OmarNeazyI/Scoppy-Oscilloscope-rp2040-PCB/images/README.md

# Project photographs

## Presentation photographs

| View | Presentation image | Original photograph |
|---|---|---|
| Enclosure | [Enclosure presentation](enclosure-presentation.png) | [Original enclosure](enclosure-original.jpg) |
| PCB component side | [PCB top presentation](pcb-top-presentation.png) | [Original PCB top](pcb-top-original.jpg) |
| PCB underside | [PCB underside presentation](pcb-bottom-presentation.png) | [Original PCB underside](pcb-bottom-original.jpg) |

## PCB design views

- [Revision A PCB layout](pcb-layout-revision-a.png) · [Original layout screenshot](pcb-layout-source.png)
- [Revision A 3D view](pcb-3d-revision-a.png) · [Original 3D screenshot](pcb-3d-source.png)
- [Revision B PCB layout](pcb-layout-revision-b.png)
- [Revision B 3D view](pcb-3d-revision-b.png)

## Additional build photographs

- [Angled PCB view](pcb-angle-original.jpg)
- [USB panel](usb-panel-original.jpg)
- [Enclosure underside](enclosure-bottom-original.jpg)

The main project page uses the presentation photographs. The original photographs are included here as additional build documentation.

[Project overview](../README.md) · [Revision A source files](../hardware/revision-a/) · [Revision B source files](../hardware/revision-b/)
