OmarNeazyI/Scoppy-Oscilloscope-rp2040-PCB/images/enclosure-bottom-original.jpg

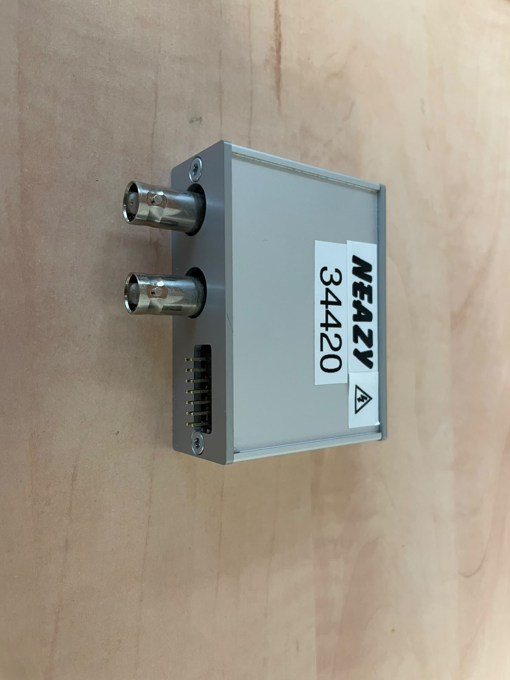
images/enclosure-bottom-original.jpg
