OmarNeazyI/Scoppy-Oscilloscope-rp2040-PCB/images/enclosure-original.jpg

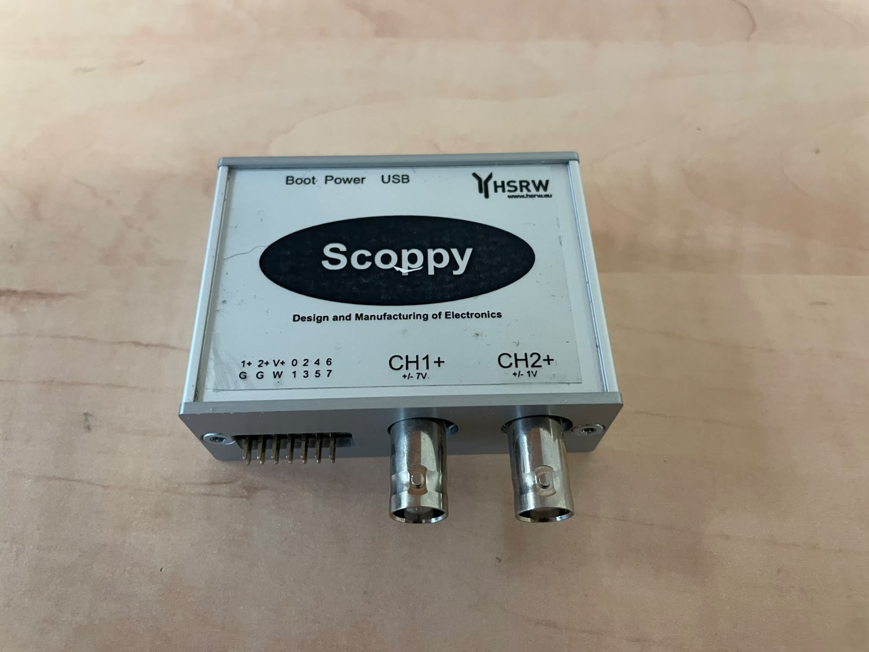
images/enclosure-original.jpg
