OmarNeazyI/Scoppy-Oscilloscope-rp2040-PCB/images/pcb-3d-source.png

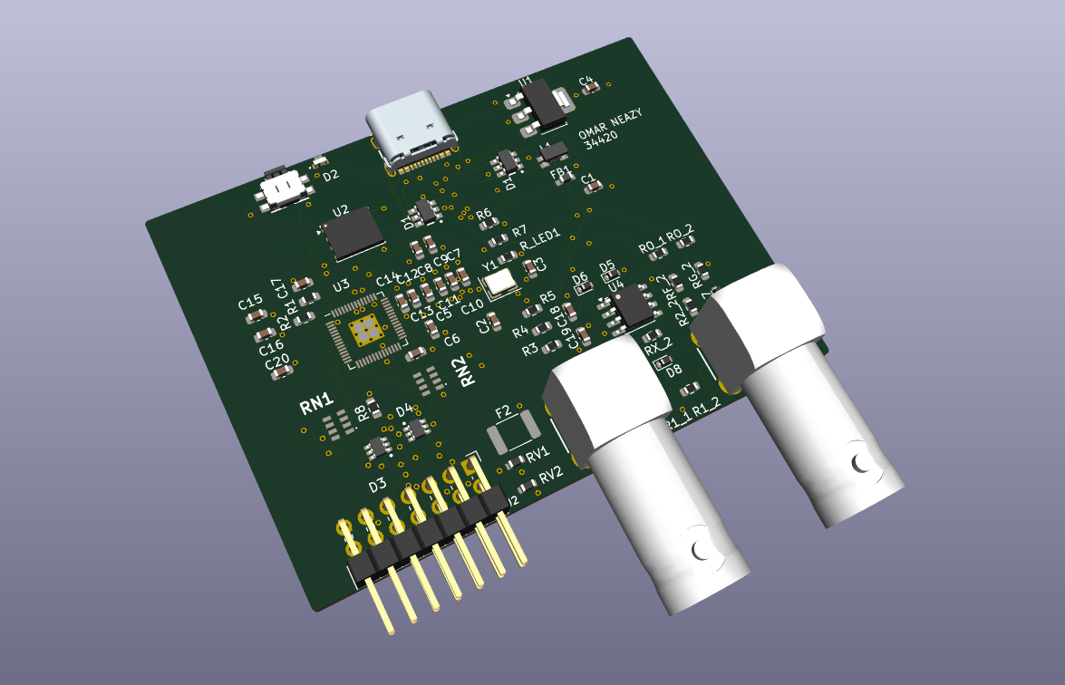
images/pcb-3d-source.png
