OmarNeazyI/Scoppy-Oscilloscope-rp2040-PCB/images/pcb-angle-original.jpg

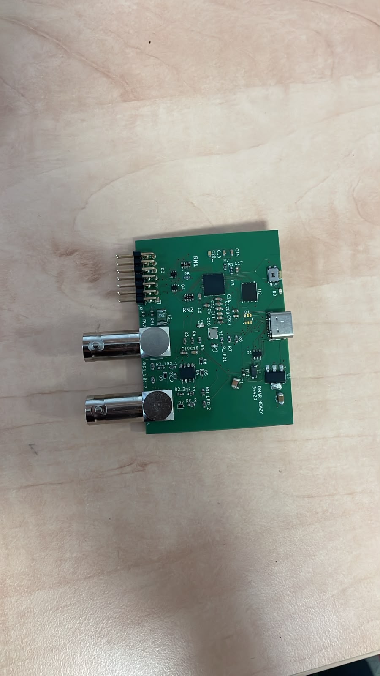
images/pcb-angle-original.jpg
