OmarNeazyI/Scoppy-Oscilloscope-rp2040-PCB/images/pcb-bottom-original.jpg

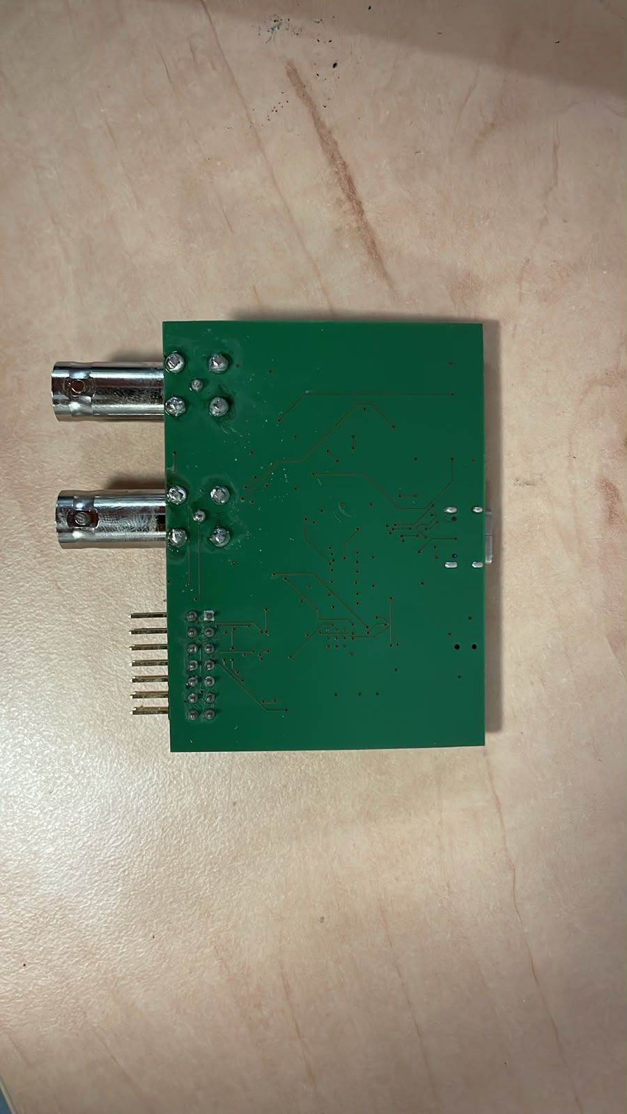
images/pcb-bottom-original.jpg
