OmarNeazyI/Scoppy-Oscilloscope-rp2040-PCB/images/pcb-layout-source.png

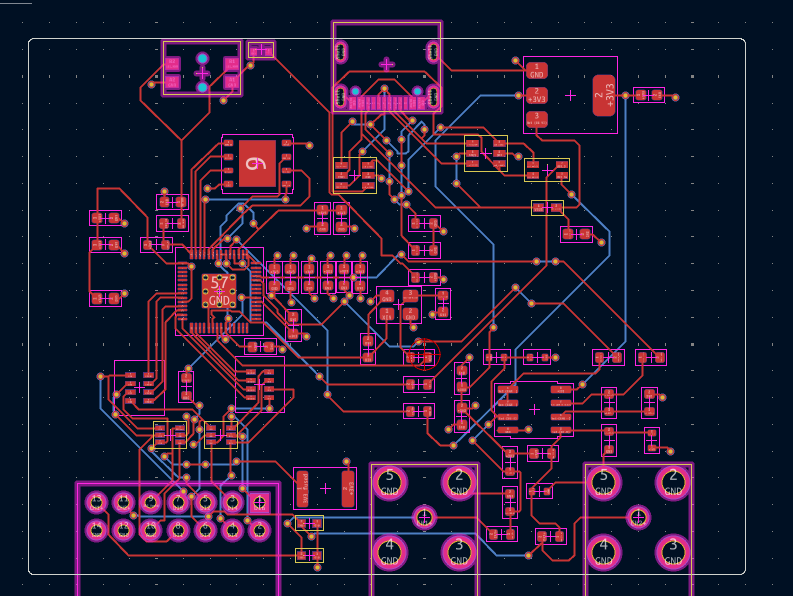
images/pcb-layout-source.png
