OmarNeazyI/Scoppy-Oscilloscope-rp2040-PCB/images/pcb-top-original.jpg

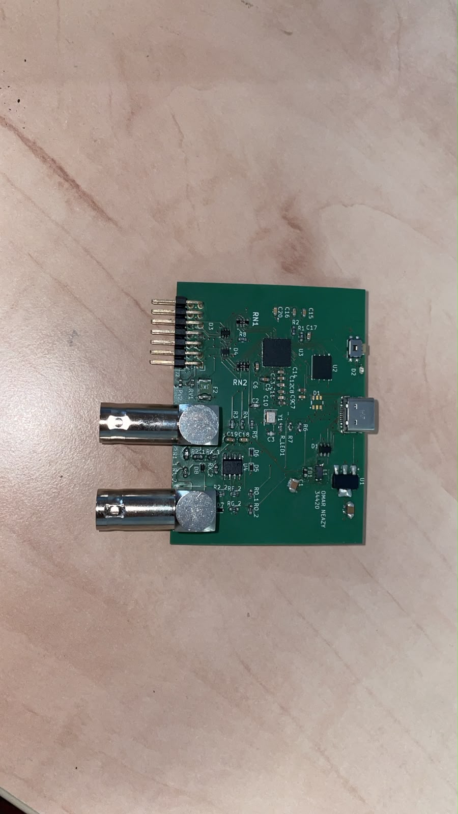
images/pcb-top-original.jpg
