OmarNeazyI/Scoppy-Oscilloscope-rp2040-PCB/images/usb-panel-original.jpg

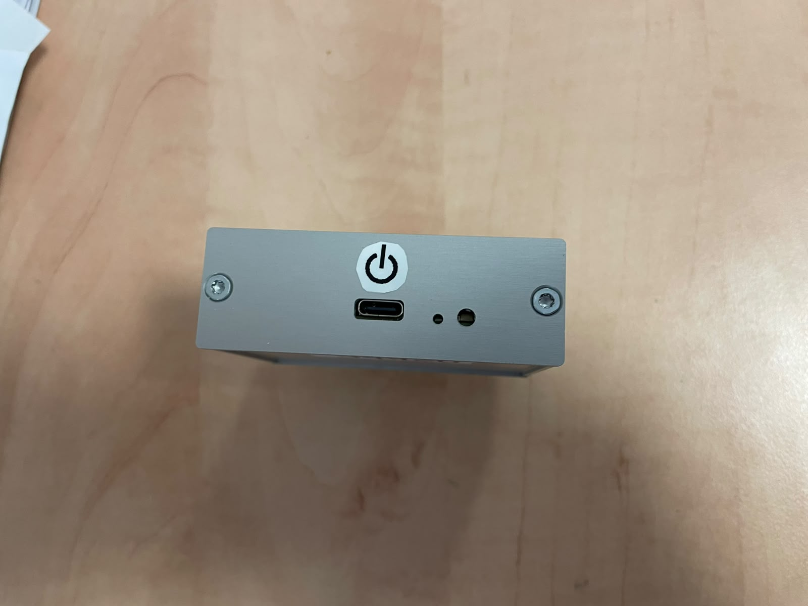
images/usb-panel-original.jpg
