OmarNeazyI/Scoppy-Oscilloscope-rp2040-PCB/hardware/revision-b/Scoppy_Revision_B.kicad_pcb

## KiCad design hardware/revision-b/Scoppy_Revision_B.kicad_pcb (2026-11-10)

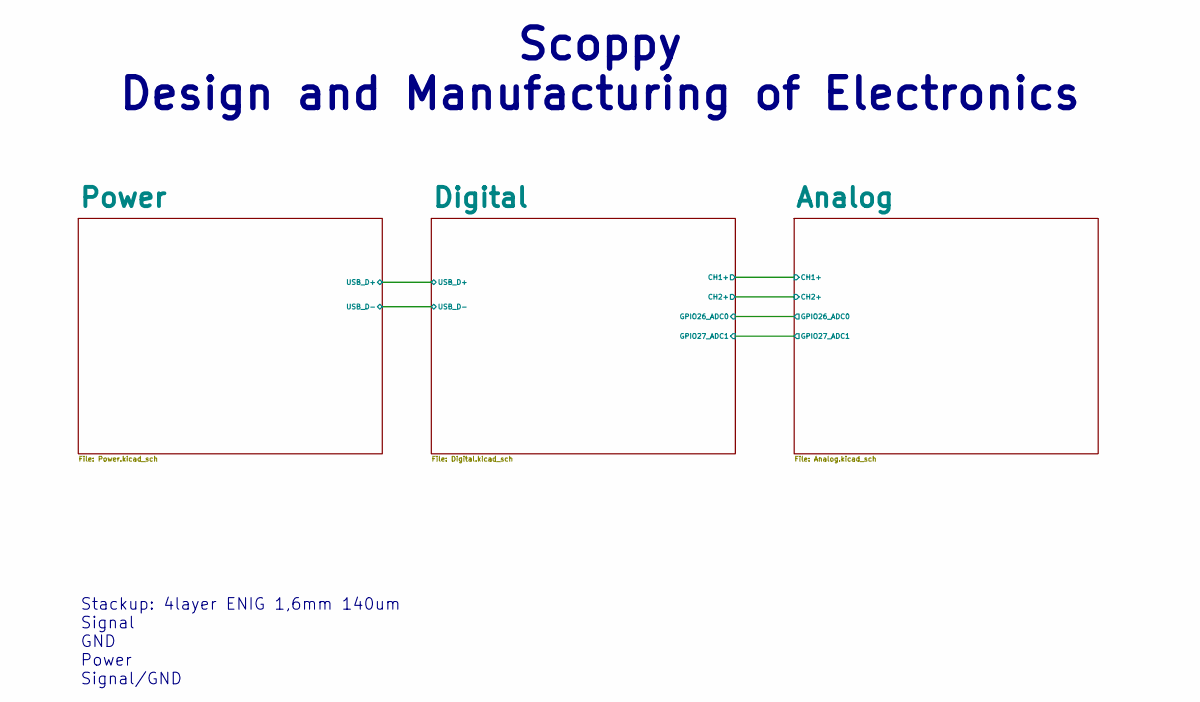
[picture p16: schematic Scoppy_Revision_B.kicad_sch, Scoppy - Design & Manufacturing of Electronics]

Notes on the sheet:
Stackup: 4layer ENIG 1,6mm 140um Signal GND Power Signal/GND
Scoppy Design and Manufacturing of Electronics

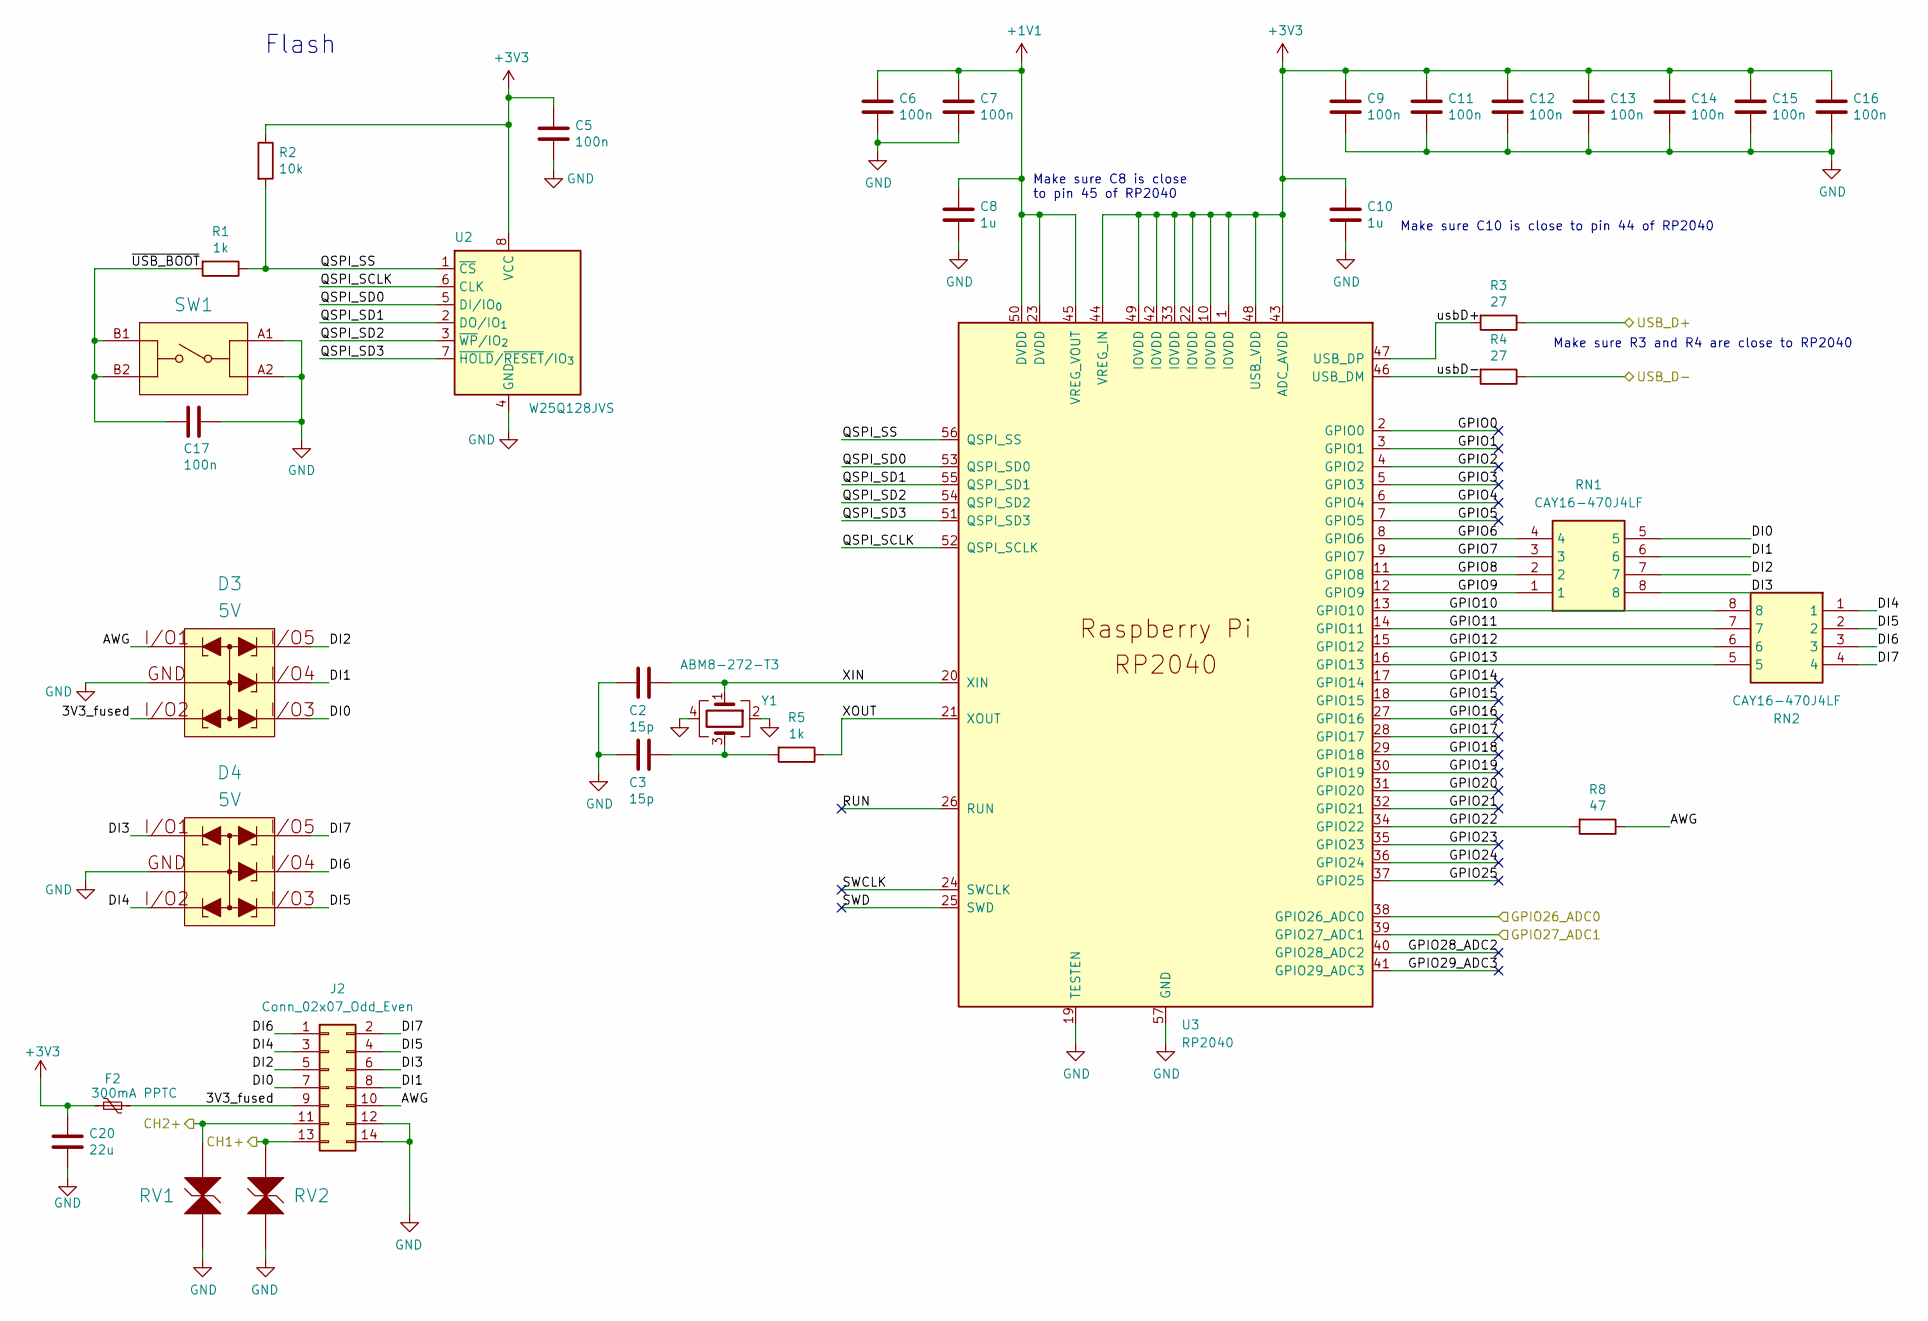
[picture p17: schematic Digital.kicad_sch, Scoppy - Design & Manufacturing of Electronics]

Parts:
C2, C3: 15p; C_0603_1608Metric
C5, C6, C7, C9, C11, C12, C13, C14, C15, C16, C17: 100n; C_0603_1608Metric
C8, C10: 1u; C_0603_1608Metric
C20: 22u; C_0603_1608Metric
D3, D4: 5V; WE-TVS_SC70-6L; Manufacturer Part Number 82402375
F2: 300mA PPTC; Fuse_1812_4532Metric
J2: Conn_02x07_Odd_Even; PinHeader_2x07_P2.54mm_Horizontal
R1, R5: 1k; R_0603_1608Metric
R2: 10k; R_0603_1608Metric
R3, R4: 27; R_0603_1608Metric
R8: 47; R_0603_1608Metric
RN1, RN2: CAY16-470J4LF; CAY16470J4LF; Mouser Part Number 652-CAY16-470J4LF
RV1, RV2: 12VDC, 5pF; WE-VE_0603; Clamping Voltage 80V; ESD Voltage 15kV; Manufacturer Part Number 82356120050
SW1: 436351045816; Rated Voltage 12VDC; Manufacturer Part Number 436351045816
U2: W25Q128JVS; SOIC-8_5.3x5.3mm_P1.27mm
U3: RP2040; RP2040-QFN-56
Y1: ABM8-272-T3; Crystal_SMD_3225-4Pin_3.2x2.5mm

Connections:
+1V1: C6.1, C7.1, C8.1, U3.23 (DVDD), U3.45 (VREG_VOUT), U3.50 (DVDD)
+3V3: C5.1, C9.1, C10.1, C11.1, C12.1, C13.1, C14.1, C15.1, C16.1, C20.1, F2.2, R2.1, U2.8 (VCC), U3.1 (IOVDD), U3.10 (IOVDD), U3.22 (IOVDD), U3.33 (IOVDD), U3.42 (IOVDD), U3.43 (ADC_AVDD), U3.44 (VREG_IN), U3.48 (USB_VDD), U3.49 (IOVDD); also elsewhere on the board
/Analog/CH1+: J2.13, RV2.2; also elsewhere on the board
/Analog/CH2+: J2.11, RV1.2; also elsewhere on the board
/Analog/GPIO26_ADC0: U3.38 (GPIO26_ADC0); also elsewhere on the board
/Analog/GPIO27_ADC1: U3.39 (GPIO27_ADC1); also elsewhere on the board
/Digital/3V3_fused: D3.3 (I/O_2), F2.1, J2.9
/Digital/AWG: D3.1 (I/O_1), J2.10, R8.1
/Digital/DI0: D3.4 (I/O_3), J2.7, RN1.5
/Digital/DI1: D3.5 (I/O_4), J2.8, RN1.6
/Digital/DI2: D3.6 (I/O_5), J2.5, RN1.7
/Digital/DI3: D4.1 (I/O_1), J2.6, RN1.8
/Digital/DI4: D4.3 (I/O_2), J2.3, RN2.1
/Digital/DI5: D4.4 (I/O_3), J2.4, RN2.2
/Digital/DI6: D4.5 (I/O_4), J2.1, RN2.3
/Digital/DI7: D4.6 (I/O_5), J2.2, RN2.4
/Digital/GPIO0: U3.2 (GPIO0)
/Digital/GPIO1: U3.3 (GPIO1)
/Digital/GPIO2: U3.4 (GPIO2)
/Digital/GPIO3: U3.5 (GPIO3)
/Digital/GPIO4: U3.6 (GPIO4)
/Digital/GPIO5: U3.7 (GPIO5)
/Digital/GPIO6: RN1.4, U3.8 (GPIO6)
/Digital/GPIO7: RN1.3, U3.9 (GPIO7)
/Digital/GPIO8: RN1.2, U3.11 (GPIO8)
/Digital/GPIO9: RN1.1, U3.12 (GPIO9)
/Digital/GPIO10: RN2.8, U3.13 (GPIO10)
/Digital/GPIO11: RN2.7, U3.14 (GPIO11)
/Digital/GPIO12: RN2.6, U3.15 (GPIO12)
/Digital/GPIO13: RN2.5, U3.16 (GPIO13)
/Digital/GPIO14: U3.17 (GPIO14)
/Digital/GPIO15: U3.18 (GPIO15)
/Digital/GPIO16: U3.27 (GPIO16)
/Digital/GPIO17: U3.28 (GPIO17)
/Digital/GPIO18: U3.29 (GPIO18)
/Digital/GPIO19: U3.30 (GPIO19)
/Digital/GPIO20: U3.31 (GPIO20)
/Digital/GPIO21: U3.32 (GPIO21)
/Digital/GPIO22: R8.2, U3.34 (GPIO22)
/Digital/GPIO23: U3.35 (GPIO23)
/Digital/GPIO24: U3.36 (GPIO24)
/Digital/GPIO25: U3.37 (GPIO25)
/Digital/GPIO28_ADC2: U3.40 (GPIO28_ADC2)
/Digital/GPIO29_ADC3: U3.41 (GPIO29_ADC3)
/Digital/QSPI_SCLK: U2.6 (CLK), U3.52 (QSPI_SCLK)
/Digital/QSPI_SD0: U2.5 (DI/IO_{0}), U3.53 (QSPI_SD0)
/Digital/QSPI_SD1: U2.2 (DO/IO_{1}), U3.55 (QSPI_SD1)
/Digital/QSPI_SD2: U2.3 (~WP/IO_{2}), U3.54 (QSPI_SD2)
/Digital/QSPI_SD3: U2.7 (~HOLD/~RESET/IO_{3}), U3.51 (QSPI_SD3)
/Digital/QSPI_SS: R1.1, R2.2, U2.1 (~CS), U3.56 (QSPI_SS)
/Digital/RUN: U3.26 (RUN)
/Digital/SWCLK: U3.24 (SWCLK)
/Digital/SWD: U3.25 (SWD)
/Digital/USB_D+: R3.1; also elsewhere on the board
/Digital/USB_D-: R4.1; also elsewhere on the board
/Digital/XIN: C2.1, U3.20 (XIN), Y1.1
/Digital/XOUT: R5.1, U3.21 (XOUT)
/Digital/usbD+: R3.2, U3.47 (USB_DP)
/Digital/usbD-: R4.2, U3.46 (USB_DM)
/Digital/~USB_BOOT: C17.1, R1.2, SW1.B1, SW1.B2
GND: C2.2, C3.2, C5.2, C6.2, C7.2, C8.2, C9.2, C10.2, C11.2, C12.2, C13.2, C14.2, C15.2, C16.2, C17.2, C20.2, D3.2 (GND), D4.2 (GND), J2.12, J2.14, RV1.1, RV2.1, SW1.A1, SW1.A2, U2.4 (GND), U3.19 (TESTEN), U3.57 (GND), Y1.2, Y1.4; also elsewhere on the board
unnamed: C3.1, R5.2, Y1.3

Notes on the sheet:
Flash
Make sure R3 and R4 are close to RP2040
Make sure C8 is close to pin 45 of RP2040
Make sure C10 is close to pin 44 of RP2040

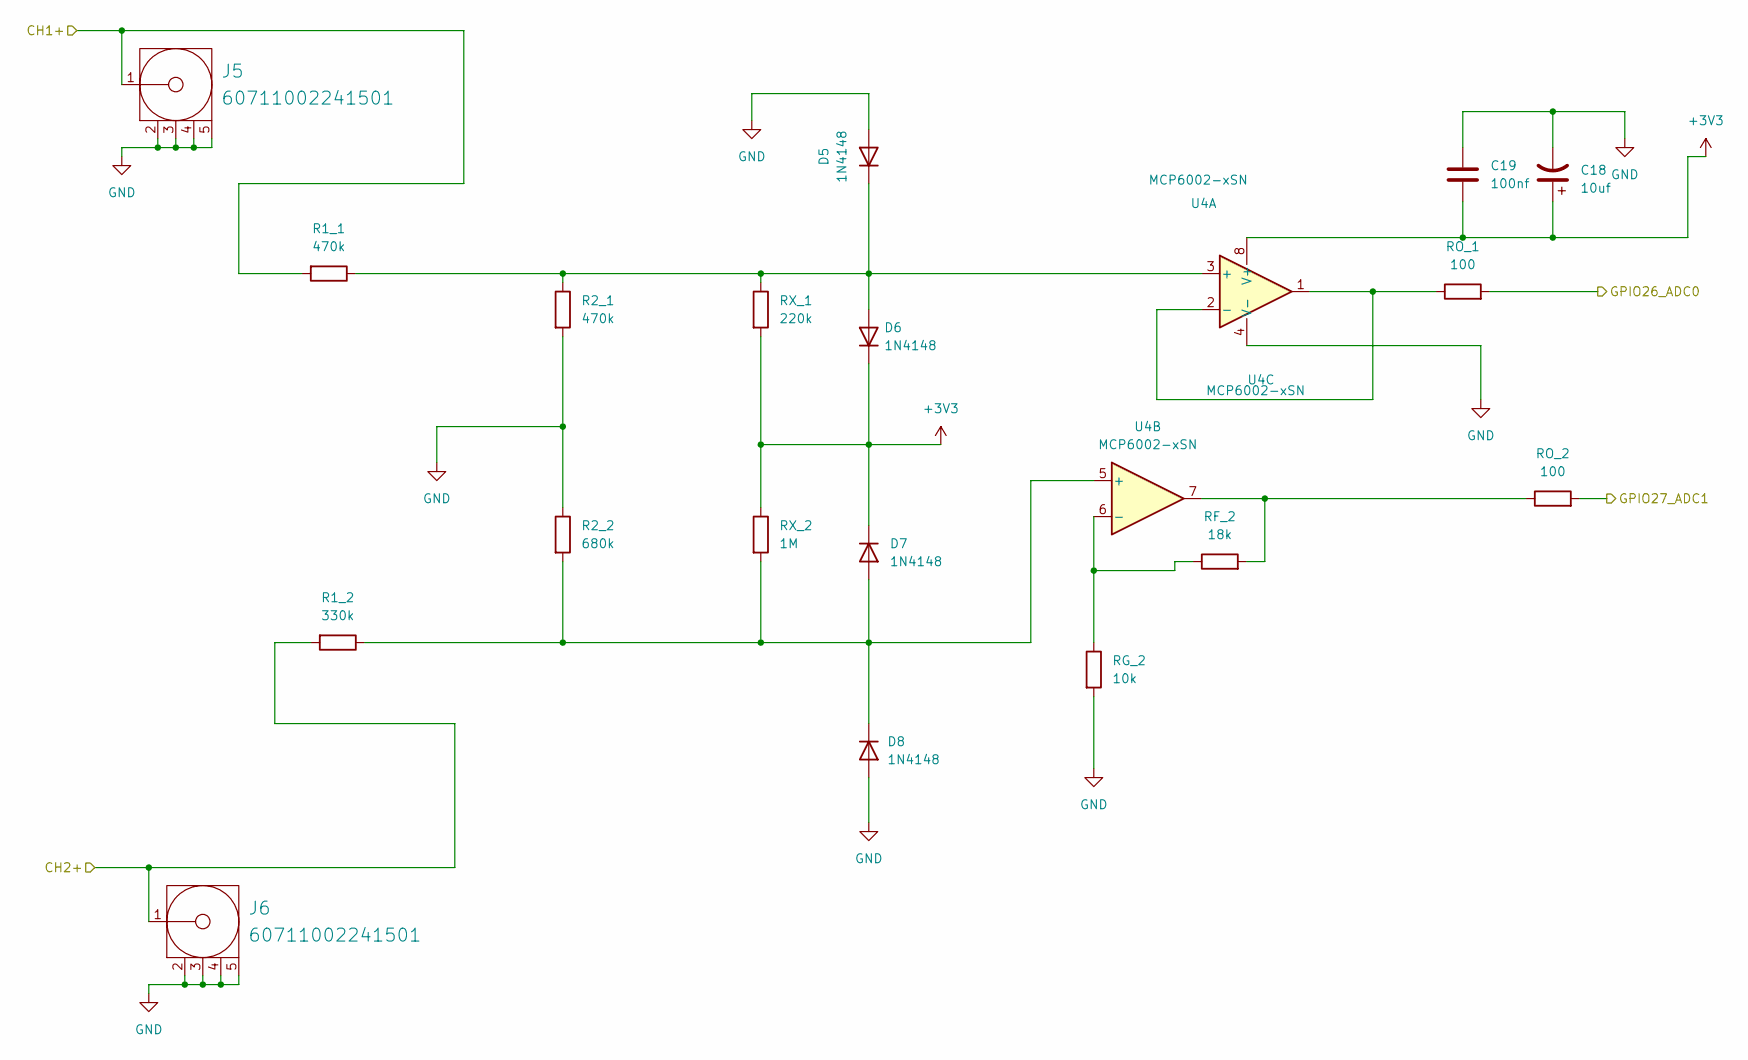
[picture p18: schematic Analog.kicad_sch, Scoppy - Design & Manufacturing of Electronics]

Parts:
C18: 10uf; C_0603_1608Metric
C19: 100nf; C_0603_1608Metric
D5, D6, D7, D8: 1N4148; D_SOD-523
J5, J6: 60711002241501; Manufacturer Part Number 60711002241501
R1_1, R2_1: 470k; R_0603_1608Metric
R1_2: 330k; R_0603_1608Metric
R2_2: 680k; R_0603_1608Metric
RF_2: 18k; R_0603_1608Metric
RG_2: 10k; R_0603_1608Metric
RO_1, RO_2: 100; R_0603_1608Metric
RX_1: 220k; R_0603_1608Metric
RX_2: 1M; R_0603_1608Metric
U4: MCP6002-xSN; SOIC-8_3.9x4.9mm_P1.27mm

Connections:
+3V3: C18.1, C19.2, D6.1 (K), D7.1 (K), RX_1.2, RX_2.1, U4.8 (V+); also elsewhere on the board
/Analog/CH1+: J5.1 (Signal), R1_1.2; also elsewhere on the board
/Analog/CH2+: J6.1 (Signal), R1_2.2; also elsewhere on the board
/Analog/GPIO26_ADC0: RO_1.2; also elsewhere on the board
/Analog/GPIO27_ADC1: RO_2.2; also elsewhere on the board
GND: C18.2, C19.1, D5.2 (A), D8.2 (A), J5.2 (GND), J5.3 (GND), J5.4 (GND), J5.5 (GND), J6.2 (GND), J6.3 (GND), J6.4 (GND), J6.5 (GND), R2_1.2, R2_2.1, RG_2.2, U4.4 (V-); also elsewhere on the board
unnamed: D5.1 (K), D6.2 (A), R1_1.1, R2_1.1, RX_1.1, U4.3 (+)
unnamed: D7.2 (A), D8.1 (K), R1_2.1, R2_2.2, RX_2.2, U4.5 (+)
unnamed: RF_2.2, RO_2.1, U4.7
unnamed: RO_1.1, U4.1, U4.2 (-)
unnamed: RF_2.1, RG_2.1, U4.6 (-)

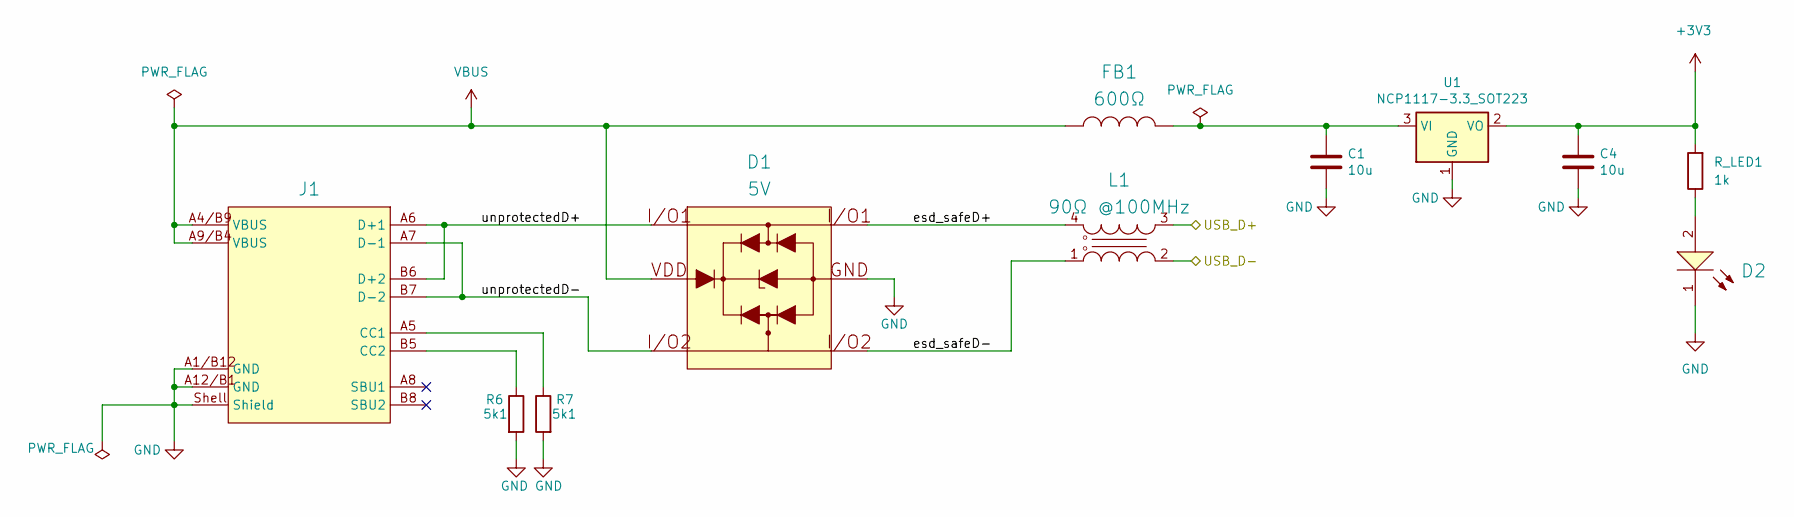
[picture p19: schematic Power.kicad_sch, Scoppy - Design & Manufacturing of Electronics]

Parts:
C1, C4: 10u; C_0603_1608Metric
D1: 5V; WE-TVS_SOT23-6L; Manufacturer Part Number 82400102
D2: Bright Green, 2V, 140°; WL-SMSW_0603_L1.6W0.98H0.8; Forward Voltage 2V; Manufacturer Part Number 155060VS75300
FB1: 600Ω; WE-CBF_0603_L1.6W0.8H0.8_HC; Manufacturer Part Number 742792651
J1: 629722000214; Working Voltage 48V (DC); Manufacturer Part Number 629722000214
L1: 90Ω @100MHz; WE-CNSW_1206; Rated Voltage 50V; Manufacturer Part Number 744232090
R6, R7: 5k1; R_0603_1608Metric
R_LED1: 1k; R_0603_1608Metric
U1: NCP1117-3.3_SOT223; SOT-223-3_TabPin2

Connections:
+3V3: C4.1, R_LED1.2, U1.2 (VO); also elsewhere on the board
/Digital/USB_D+: L1.3; also elsewhere on the board
/Digital/USB_D-: L1.2; also elsewhere on the board
/Power/esd_safeD+: D1.1 (I/O_1), L1.4
/Power/esd_safeD-: D1.3 (I/O_2), L1.1
/Power/unprotectedD+: D1.6 (I/O_1), J1.A6 (D+1), J1.B6 (D+2)
/Power/unprotectedD-: D1.4 (I/O_2), J1.A7 (D-1), J1.B7 (D-2)
GND: C1.2, C4.2, D1.2 (GND), D2.1 (K), J1.A1/B12 (GND), J1.A12/B1 (GND), J1.Shell (Shield), R6.2, R7.2, U1.1 (GND); also elsewhere on the board
unnamed: D2.2 (A), R_LED1.1
unnamed: J1.A5 (CC1), R7.1
unnamed: J1.B5 (CC2), R6.1
unnamed: C1.1, FB1.2, U1.3 (VI)
VBUS: D1.5 (VDD), FB1.1, J1.A4/B9 (VBUS), J1.A9/B4 (VBUS)

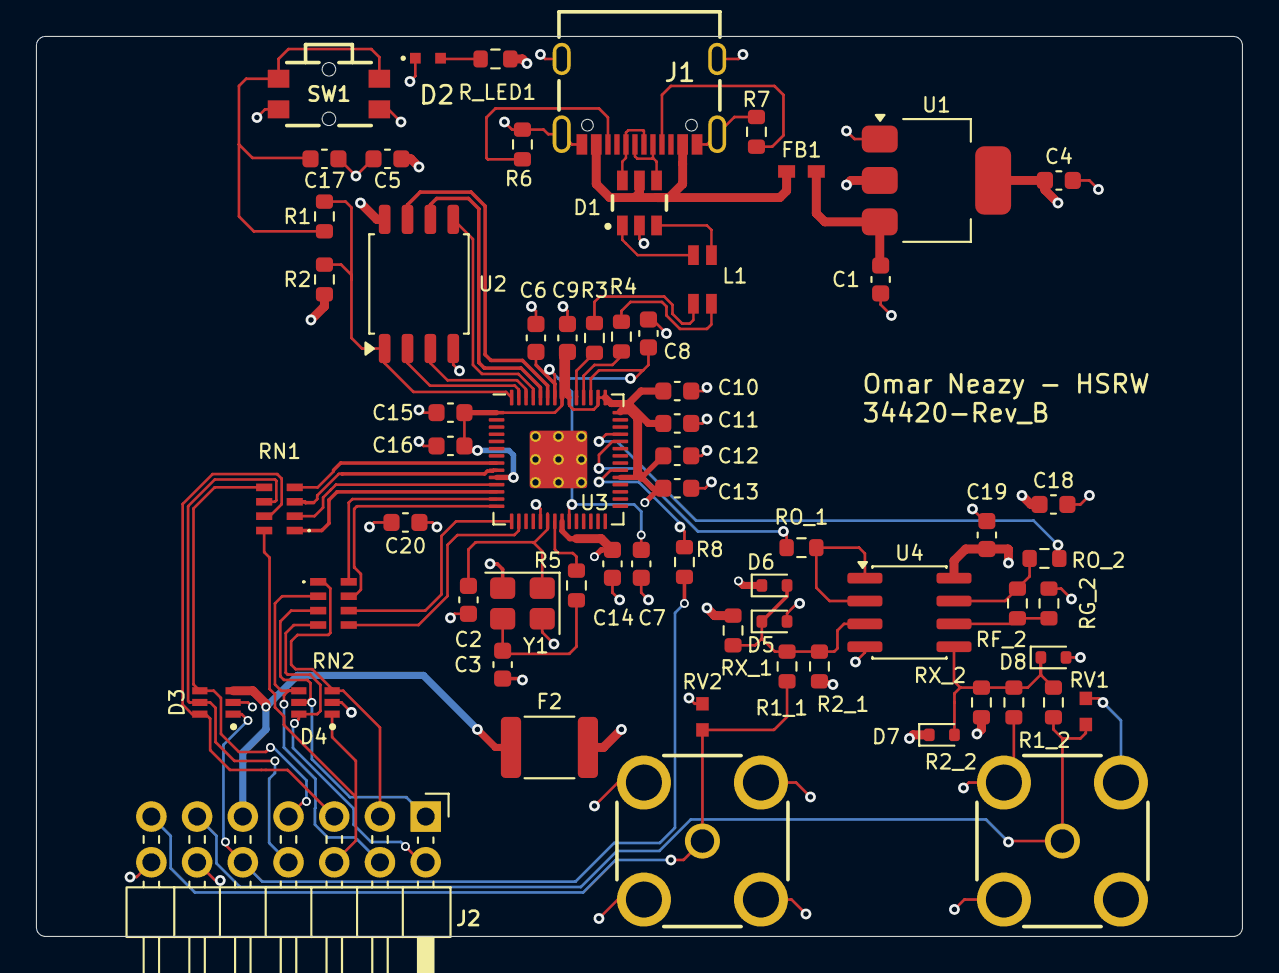
[picture p20: board Scoppy_Revision_B.kicad_pcb from above]

Board: 4 copper layers, 67.0 x 50.0 mm, 64 parts (0 on the bottom side), 54 nets.
