OmarNeazyI/Scoppy-Oscilloscope-rp2040-PCB/(commit log)

2026-10-17 Added Scoppy project files and documentation
    [Analog.kicad_sch, Digital.kicad_sch, Power.kicad_sch, Scoppy34420file.kicad_pcb, Scoppy34420file.kicad_sch]
2026-11-10 Add files via upload
    Added Revision B PCB layout and documentation.
    [Analog.kicad_sch, Digital.kicad_sch, Power.kicad_sch, Scoppy_Revision_B.kicad_pcb, Scoppy_Revision_B.kicad_sch]
